Kirseline/PCB-OVEN/Documentation/pics/board_top_comp.JPG

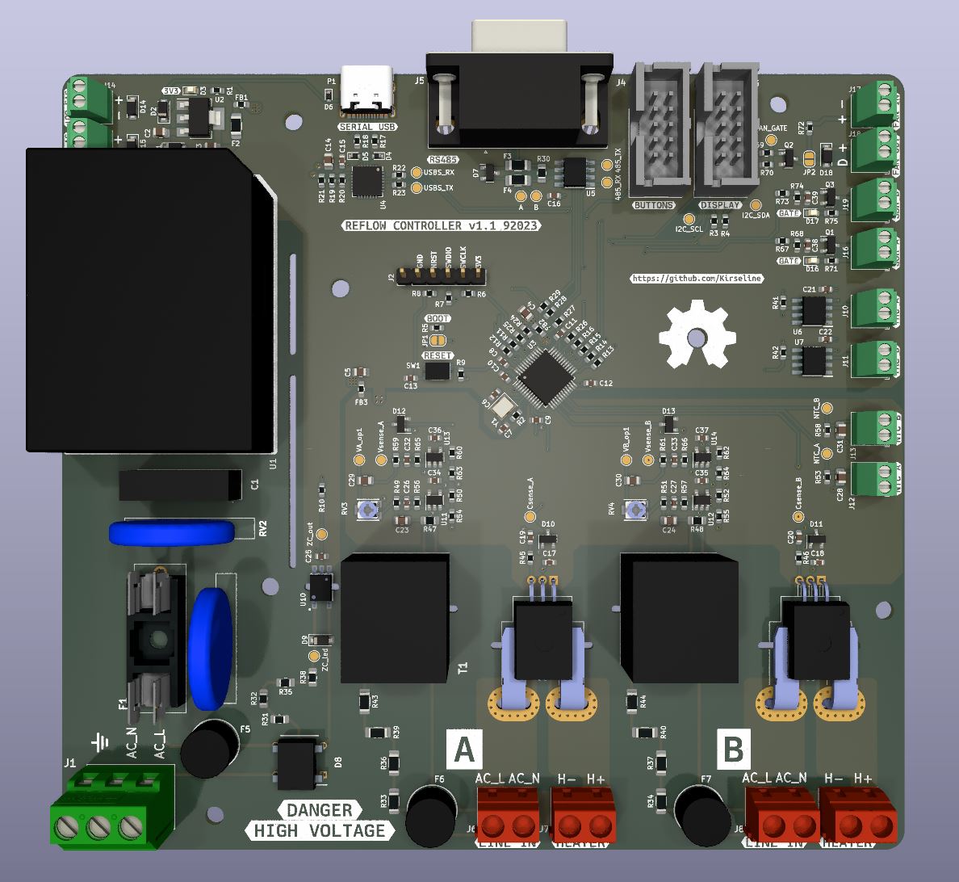
Documentation/pics/board_top_comp.JPG
