Kirseline/PCB-OVEN/Documentation/pics/board_comp.JPG

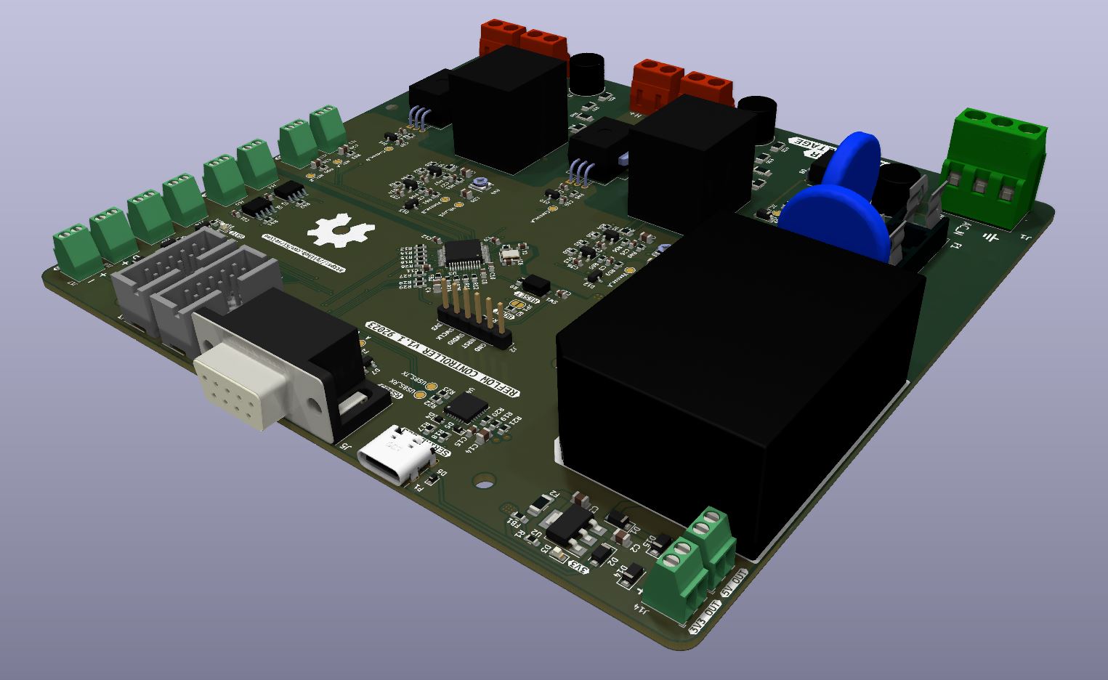
Documentation/pics/board_comp.JPG
