Kirseline/PCB-OVEN/MECHANICAL/chamber dimension.ods

Oven chamber dimension [m]:
height: | 0.275
length: | 0.019
width: | 0.260
volume[m³]: | 0.0013585
