Kirseline/PCB-OVEN/Documentation/pics/board_bot.JPG

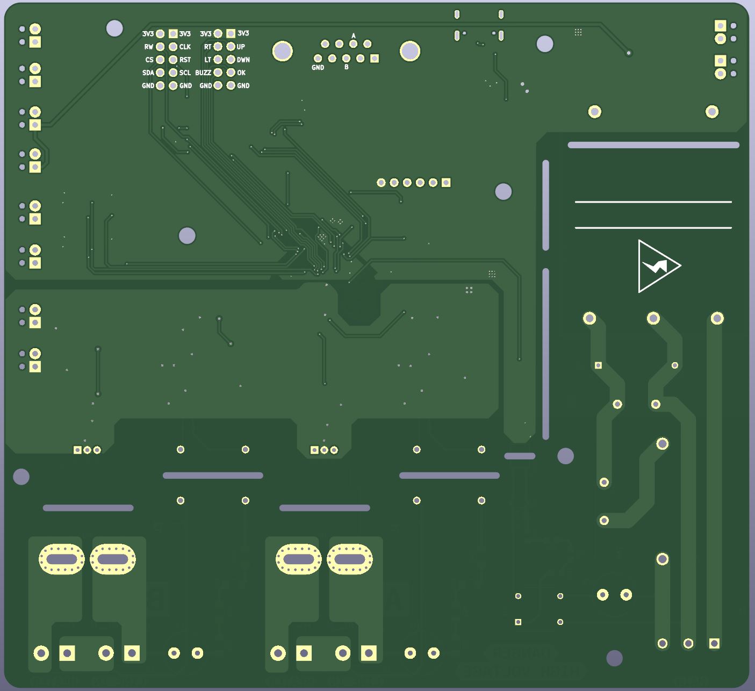
Documentation/pics/board_bot.JPG
