Kirseline/PCB-OVEN/Documentation/pics/board_top.JPG

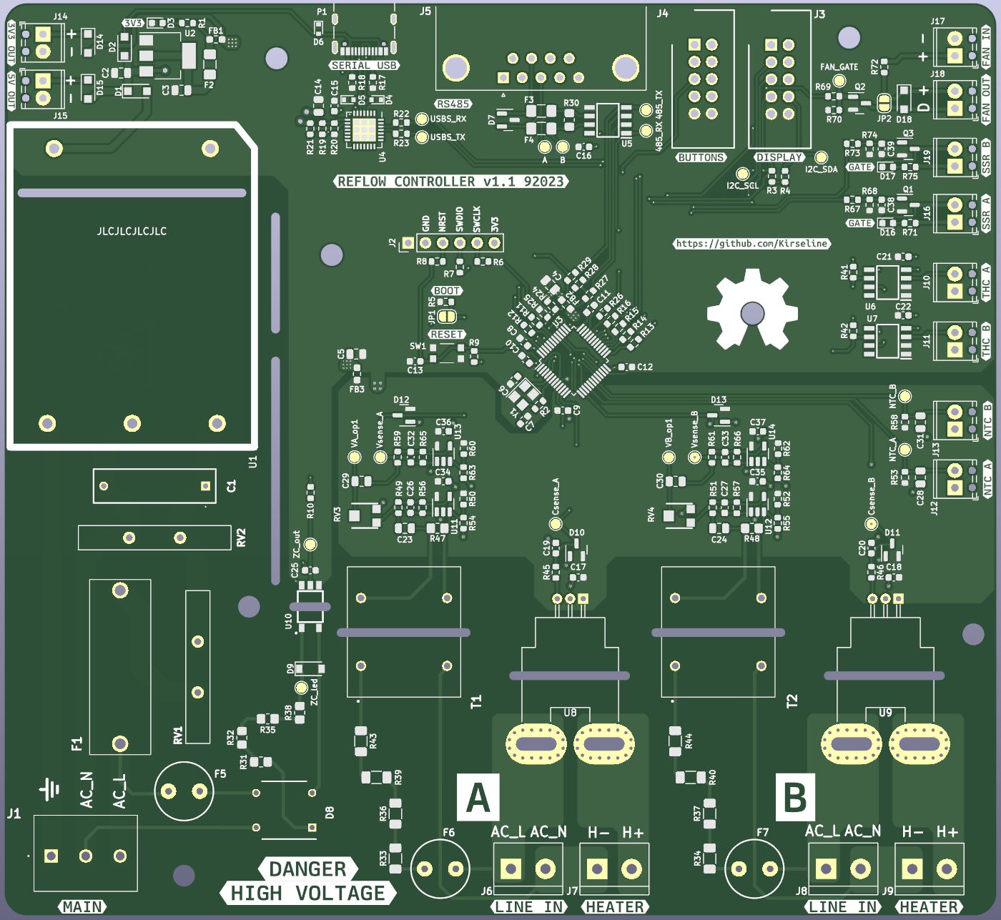
Documentation/pics/board_top.JPG
