Kirseline/PCB-OVEN/(threads)

Thread 1 (2023-09-15):

wrong footprint

Kirseline, 2023-09-15:
AC-DC converter LH05-10B05 footprint is wrong. Pin 8 and 4 should be swapped

Thread 2 (2024-12-19):

ZERO CROSSING NOISY

Kirseline, 2024-12-19:
noise problem in the zero crossing signal making it unusable

Kirseline, 2024-12-19:
added 1uF capacitor

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
