Kirseline/PCB-OVEN/Electrical/pcb/reflow_oven/fab/User Boards.pdf

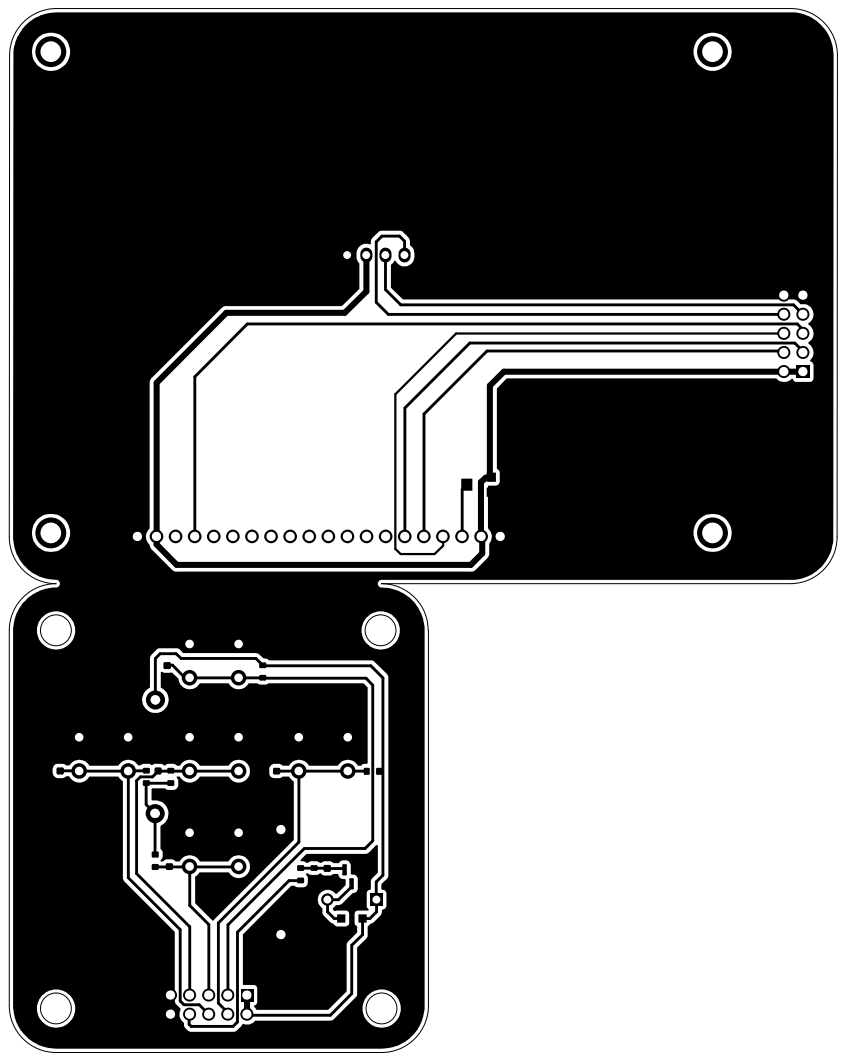
[picture p27: page 1]
