Kirseline/PCB-OVEN/Electrical/pcb/reflow_oven/UserBoard/User Board/User Board.kicad_pcb

## KiCad design Electrical/pcb/reflow_oven/UserBoard/User Board/User Board.kicad_pcb (2023-09-07)

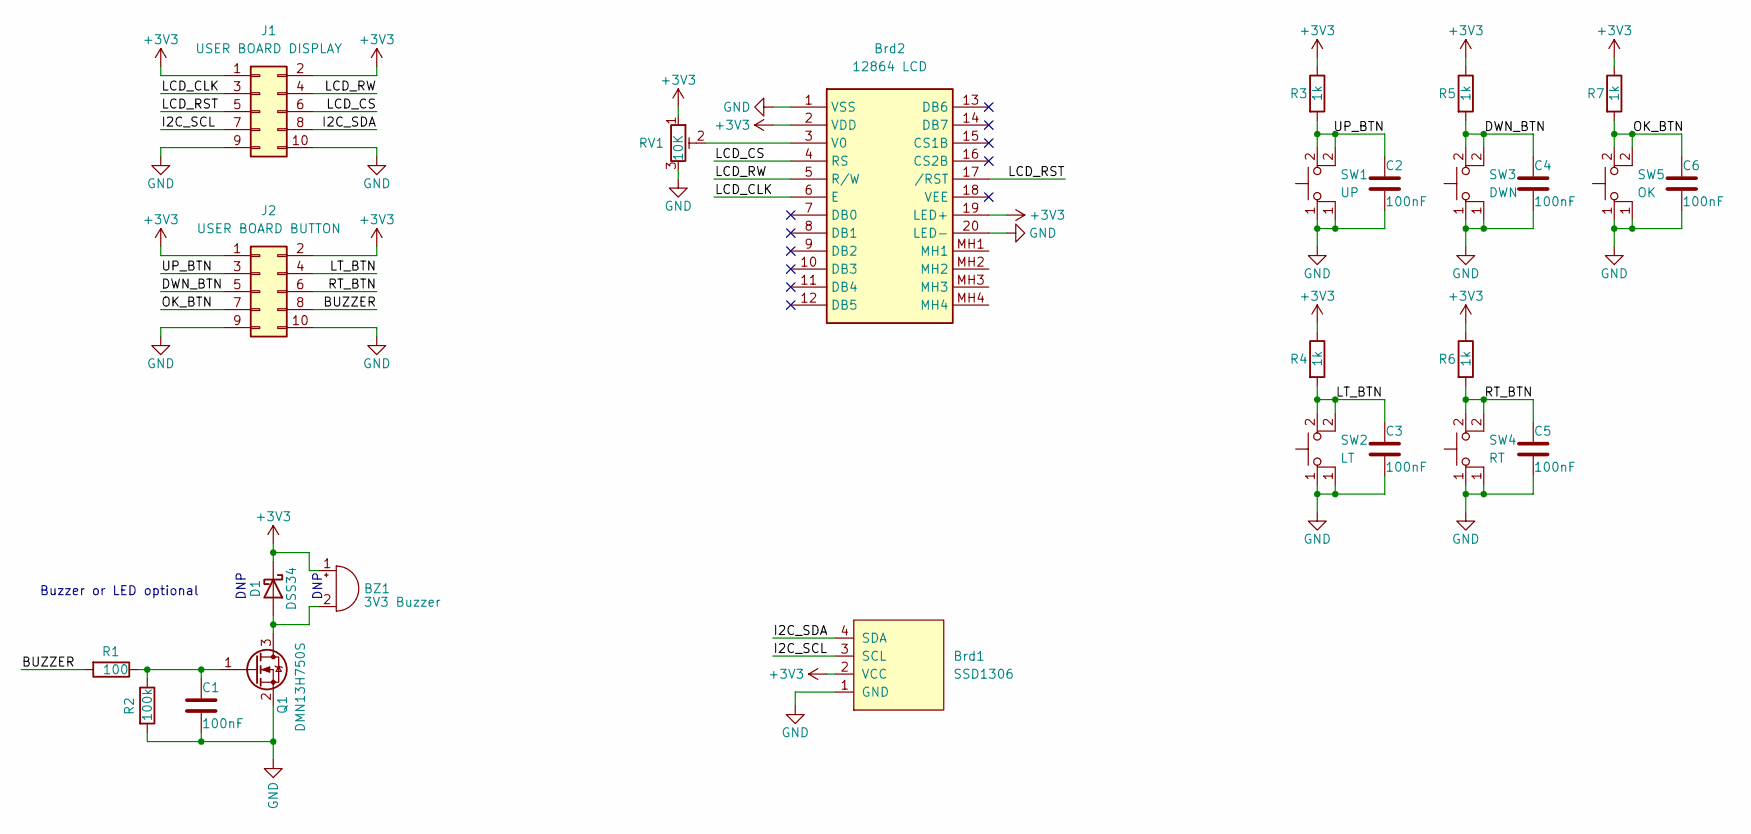
[picture p28: schematic User Board.kicad_sch]

Parts:
BZ1: 3V3 Buzzer; MagneticBuzzer_ProSignal_ABT-410-RC
Brd1: SSD1306; 128x64OLED
Brd2: 12864 LCD; NHD12864AZFSWGBWVZ; Manufacturer_Part_Number NHD-12864AZ-FSW-GBW-VZ; Mouser Part Number 763-12864AZ-FSW-GBW
C1, C2, C3, C4, C5, C6: 100nF; C_0603_1608Metric
D1: DSS34; D_SOD-123F
J1: USER BOARD DISPLAY; SHDR10W66P254_2X5_2019X914X986P
J2: USER BOARD BUTTON; SHDR10W66P254_2X5_2019X914X986P
Q1: DMN13H750S; SOT-23
R1: 100; R_0603_1608Metric
R2: 100k; R_0603_1608Metric
R3, R4, R5, R6, R7: 1k; R_0603_1608Metric
RV1: 10K; TC33X2503E
SW1: UP; SW_PUSH_6mm
SW2: LT; SW_PUSH_6mm
SW3: DWN; SW_PUSH_6mm
SW4: RT; SW_PUSH_6mm
SW5: OK; SW_PUSH_6mm

Connections:
+3V3: BZ1.1 (-), Brd1.2 (VCC), Brd2.2 (VDD), Brd2.19 (LED+), D1.1 (K), J1.1, J1.2, J2.1, J2.2, R3.1, R4.1, R5.1, R6.1, R7.1, RV1.1
/BUZZER: J2.8, R1.2
/DWN_BTN: C4.1, J2.5, R5.2, SW3.2
/I2C_SCL: Brd1.3 (SCL), J1.7
/I2C_SDA: Brd1.4 (SDA), J1.8
/LCD_CLK: Brd2.6 (E), J1.3
/LCD_CS: Brd2.4 (RS), J1.6
/LCD_RST: Brd2.17 (/RST), J1.5
/LCD_RW: Brd2.5 (R/W), J1.4
/LT_BTN: C3.1, J2.4, R4.2, SW2.2
/OK_BTN: C6.1, J2.7, R7.2, SW5.2
/RT_BTN: C5.1, J2.6, R6.2, SW4.2
/UP_BTN: C2.1, J2.3, R3.2, SW1.2
GND: Brd1.1 (GND), Brd2.1 (VSS), Brd2.20 (LED-), C1.2, C2.2, C3.2, C4.2, C5.2, C6.2, J1.9, J1.10, J2.9, J2.10, Q1.2 (S), R2.2, RV1.3, SW1.1, SW2.1, SW3.1, SW4.1, SW5.1
unnamed: BZ1.2 (+), D1.2 (A), Q1.3 (D)
unnamed: Brd2.3 (V0), RV1.2
unnamed: C1.1, Q1.1 (G), R1.1, R2.1

Notes on the sheet:
DNP
Buzzer or LED optional

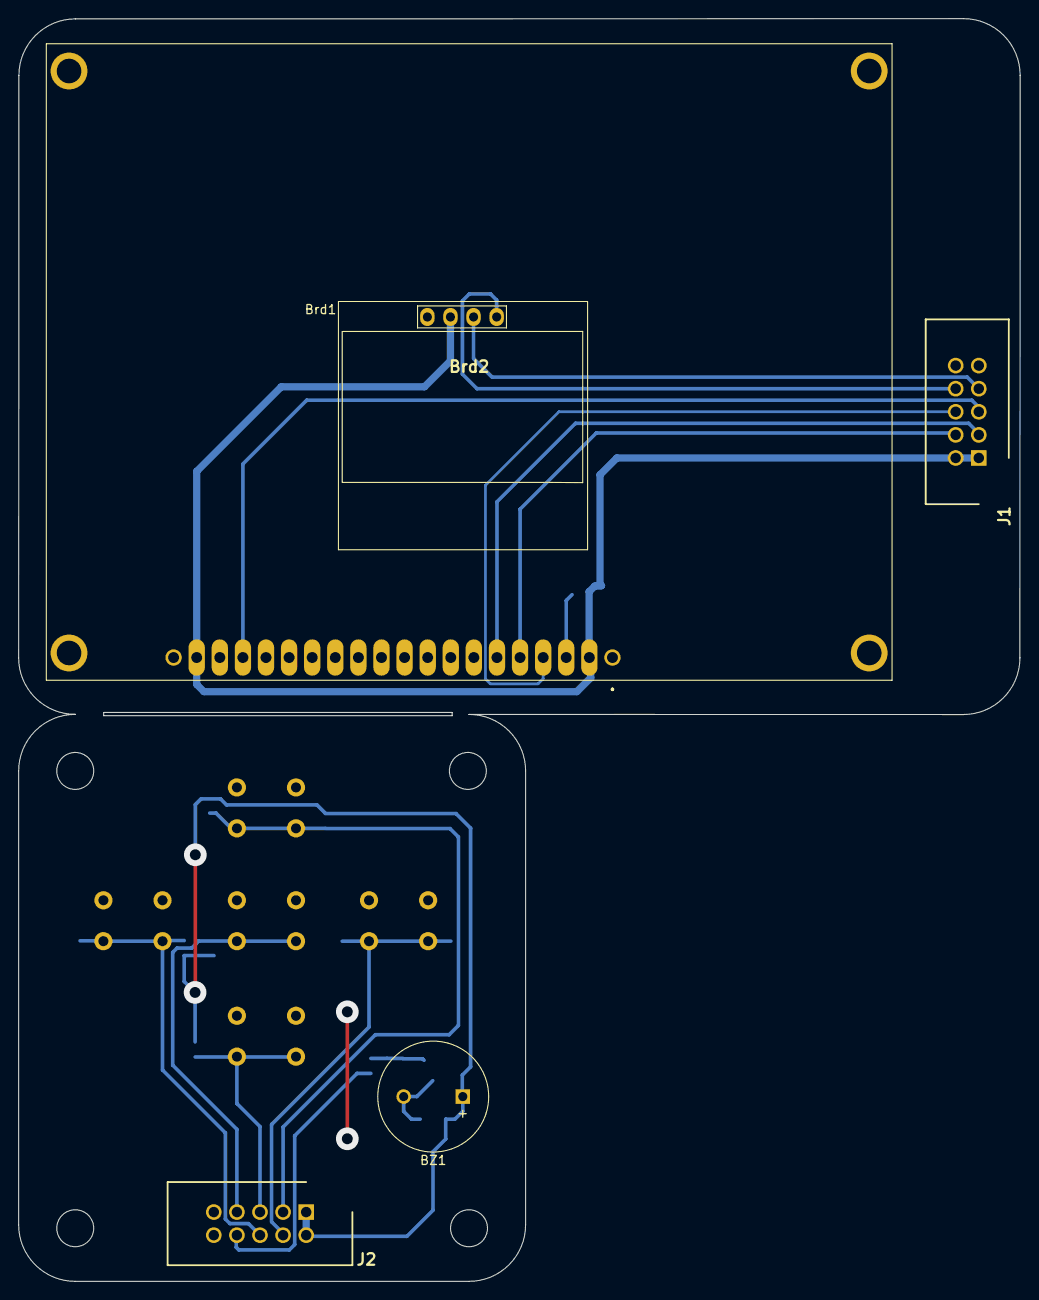
[picture p29: board User Board.kicad_pcb from above]

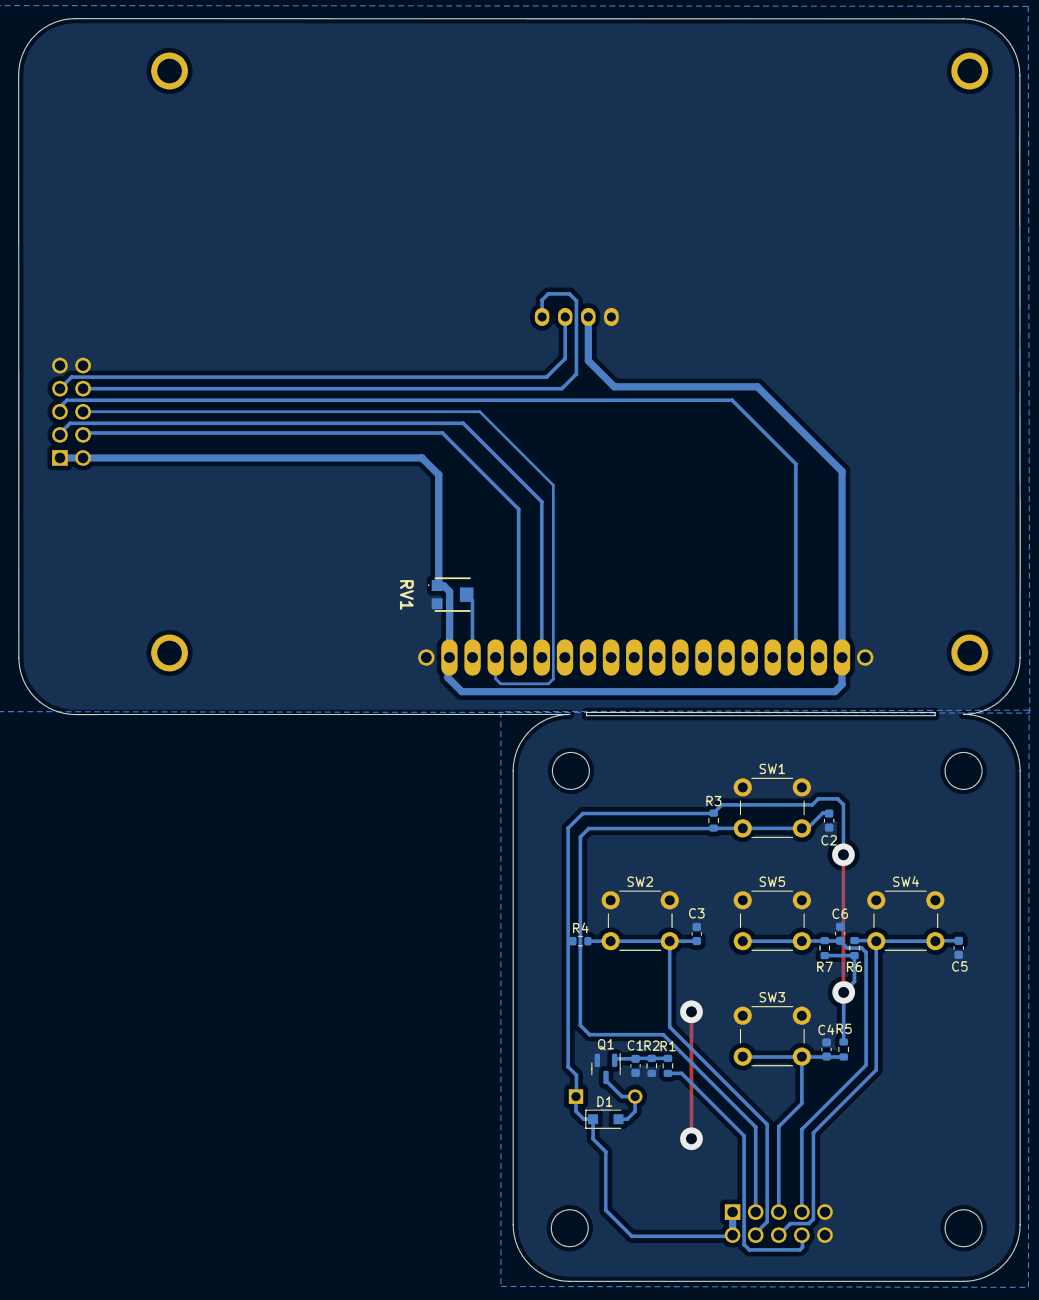
[picture p30: board User Board.kicad_pcb from below]

Board: 2 copper layers, 110.1 x 138.9 mm, 26 parts (21 on the bottom side), 17 nets.
