Kirseline/PCB-OVEN/Electrical/pcb/reflow_oven/reflow_oven.kicad_pcb

## KiCad design Electrical/pcb/reflow_oven/reflow_oven.kicad_pcb (2023-08-26)

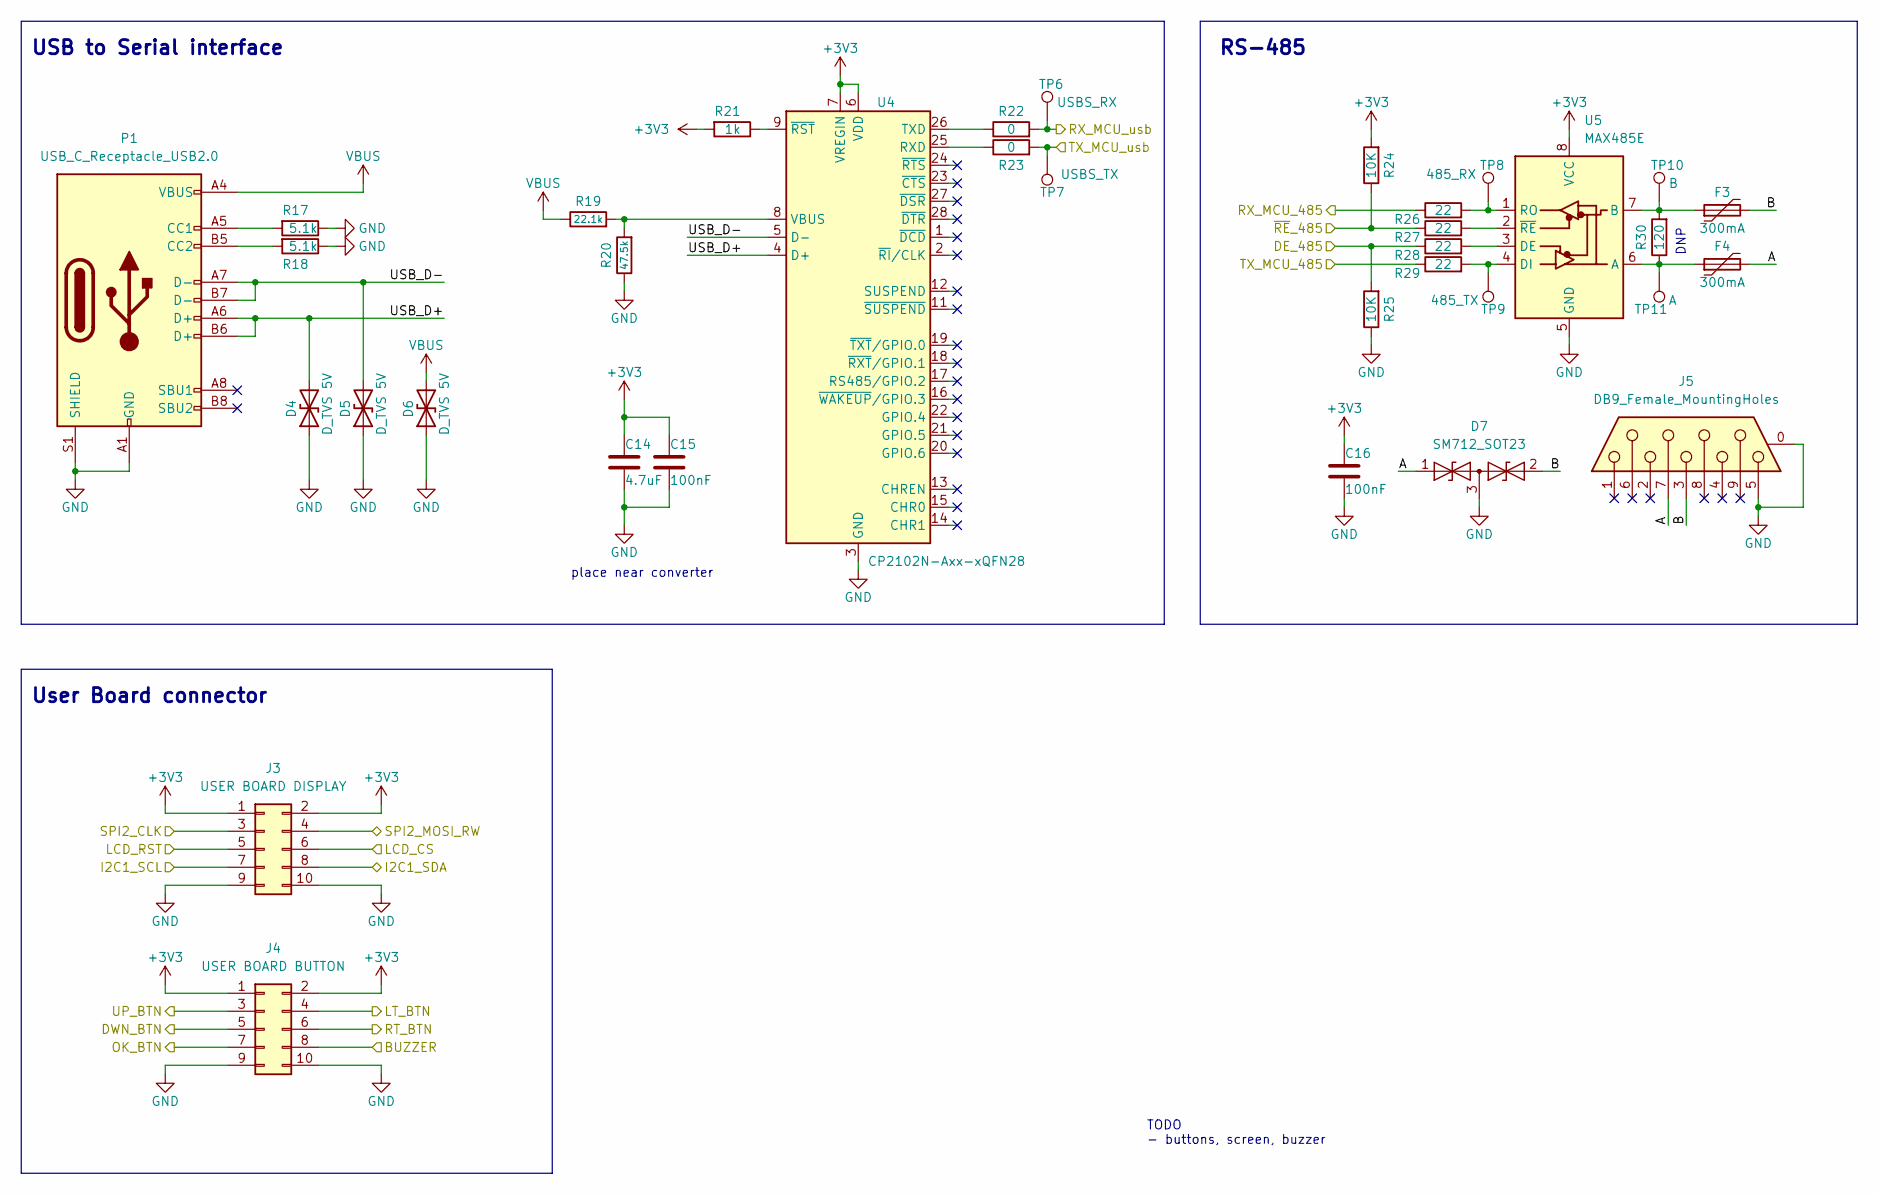
[picture p31: schematic Interfaces.kicad_sch, Reflow Controller]

Parts:
C14: 4.7uF; C_0805_2012Metric
C15, C16: 100nF; C_0603_1608Metric
D4, D5, D6: D_TVS 5V; D_SOD-523
D7: SM712_SOT23; SOT-23
F3, F4: 300mA; Fuse_1206_3216Metric_Pad1.42x1.75mm_HandSolder
J3: USER BOARD DISPLAY; SHDR10W66P254_2X5_2019X914X986P
J4: USER BOARD BUTTON; SHDR10W66P254_2X5_2019X914X986P
J5: DB9_Female_MountingHoles; DSUB-9_Female_Horizontal_P2.77x2.84mm_EdgePinOffset7.70mm_H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
P1: USB_C_Receptacle_USB2.0; USB_C_Receptacle_Palconn_UTC16-G
R17, R18: 5.1k; R_0603_1608Metric
R19: 22.1k; R_0603_1608Metric
R20: 47.5k; R_0603_1608Metric
R21: 1k; R_0603_1608Metric
R22, R23: 0; R_0603_1608Metric
R24, R25: 10K; R_0603_1608Metric
R26, R27, R28, R29: 22; R_0603_1608Metric
R30: 120; R_0805_2012Metric_Pad1.20x1.40mm_HandSolder
TP6: USBS_RX; TestPoint_Pad_D1.5mm
TP7: USBS_TX; TestPoint_Pad_D1.5mm
TP8: 485_RX; TestPoint_Pad_D1.5mm
TP9: 485_TX; TestPoint_Pad_D1.5mm
TP10: B; TestPoint_Pad_D1.5mm
TP11: A; TestPoint_Pad_D1.5mm
U4: CP2102N-Axx-xQFN28; QFN-28-1EP_5x5mm_P0.5mm_EP3.35x3.35mm
U5: MAX485E; SOIC127P600X175-8N

Connections:
+3V3: C14.1, C15.1, C16.1, J3.1, J3.2, J4.1, J4.2, R21.2, R24.2, U4.6 (VDD), U4.7 (VREGIN), U5.8 (VCC); also elsewhere on the board
/Interfaces/A: D7.1 (A1), F4.2, J5.7
/Interfaces/B: D7.2 (A2), F3.2, J5.3
/Interfaces/BUZZER: J4.8; also elsewhere on the board
/Interfaces/DE_485: R25.2, R28.1; also elsewhere on the board
/Interfaces/DWN_BTN: J4.5; also elsewhere on the board
/Interfaces/LCD_CS: J3.6; also elsewhere on the board
/Interfaces/LCD_RST: J3.5; also elsewhere on the board
/Interfaces/LT_BTN: J4.4; also elsewhere on the board
/Interfaces/OK_BTN: J4.7; also elsewhere on the board
/Interfaces/RT_BTN: J4.6; also elsewhere on the board
/Interfaces/RX_MCU_485: R26.1; also elsewhere on the board
/Interfaces/RX_MCU_usb: R22.2, TP6.1; also elsewhere on the board
/Interfaces/SPI2_CLK: J3.3; also elsewhere on the board
/Interfaces/SPI2_MOSI_RW: J3.4; also elsewhere on the board
/Interfaces/TX_MCU_485: R29.1; also elsewhere on the board
/Interfaces/TX_MCU_usb: R23.2, TP7.1; also elsewhere on the board
/Interfaces/UP_BTN: J4.3; also elsewhere on the board
/Interfaces/USB_D+: D4.2 (A2), P1.A6 (D+), P1.B6 (D+), U4.4 (D+)
/Interfaces/USB_D-: D5.2 (A2), P1.A7 (D-), P1.B7 (D-), U4.5 (D-)
/Interfaces/~RE_485: R24.1, R27.1; also elsewhere on the board
/MCU_User/I2C1_SCL: J3.7; also elsewhere on the board
/MCU_User/I2C1_SDA: J3.8; also elsewhere on the board
GND: C14.2, C15.2, C16.2, D4.1 (A1), D5.1 (A1), D6.1 (A1), D7.3 (common), J3.9, J3.10, J4.9, J4.10, J5.0 (PAD), J5.5, P1.A1 (GND), P1.A12 (GND), P1.B1 (GND), P1.B12 (GND), P1.S1 (SHIELD), R17.1, R18.1, R20.1, R25.1, U4.3 (GND), U4.29 (GND), U5.5 (GND); also elsewhere on the board
unnamed: F3.1, R30.2, TP10.1, U5.7 (B)
unnamed: F4.1, R30.1, TP11.1, U5.6 (A)
unnamed: P1.A5 (CC1), R17.2
unnamed: P1.B5 (CC2), R18.2
unnamed: R19.2, R20.2, U4.8 (VBUS)
unnamed: R21.1, U4.9 (~RST)
unnamed: R22.1, U4.26 (TXD)
unnamed: R23.1, U4.25 (RXD)
unnamed: R26.2, TP8.1, U5.1 (RO)
unnamed: R27.2, U5.2 (~RE)
unnamed: R28.2, U5.3 (DE)
unnamed: R29.2, TP9.1, U5.4 (DI)
VBUS: D6.2 (A2), P1.A4 (VBUS), P1.A9 (VBUS), P1.B4 (VBUS), P1.B9 (VBUS), R19.1; also elsewhere on the board

Notes on the sheet:
DNP
TODO - buttons, screen, buzzer
User Board connector
RS-485
place near converter
USB to Serial interface

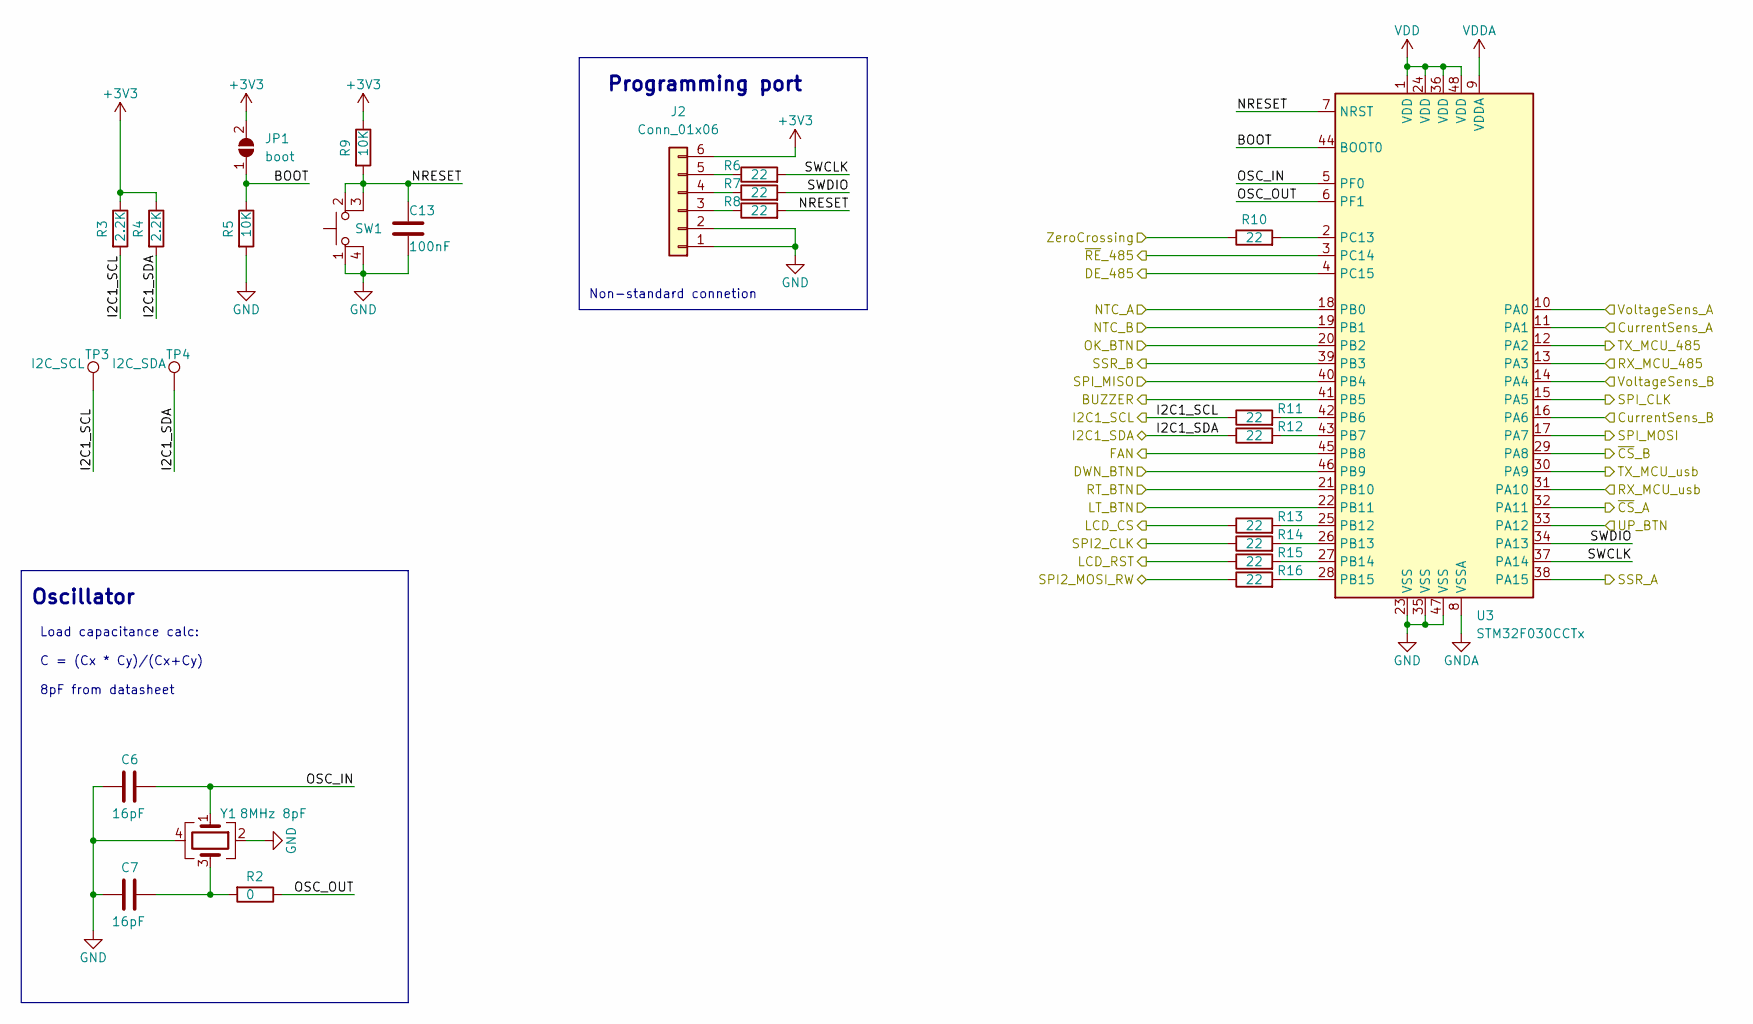
[picture p32: schematic MCU_User.kicad_sch, Reflow Controller]

Parts:
C6, C7: 16pF; C_0603_1608Metric
C13: 100nF; C_0603_1608Metric
J2: Conn_01x06; PinHeader_1x06_P2.54mm_Vertical
JP1: boot; SolderJumper-2_P1.3mm_Open_RoundedPad1.0x1.5mm
R2: 0; R_0603_1608Metric
R3, R4: 2.2K; R_0603_1608Metric
R5, R9: 10K; R_0603_1608Metric
R6, R7, R8, R10, R11, R12, R13, R14, R15, R16: 22; R_0603_1608Metric
SW1: SW_MEC_5E; KMR621NGLFS
TP3: I2C_SCL; TestPoint_Pad_D1.5mm
TP4: I2C_SDA; TestPoint_Pad_D1.5mm
U3: STM32F030CCTx; LQFP-48_7x7mm_P0.5mm
Y1: 8MHz 8pF; Crystal_SMD_TXC_7M-4Pin_3.2x2.5mm

Connections:
+3V3: J2.6, JP1.2 (B), R3.1, R4.1, R9.1; also elsewhere on the board
/Actuation/FAN: U3.45 (PB8); also elsewhere on the board
/Actuation/SSR_A: U3.38 (PA15); also elsewhere on the board
/Actuation/SSR_B: U3.39 (PB3); also elsewhere on the board
/Interfaces/BUZZER: U3.41 (PB5); also elsewhere on the board
/Interfaces/DE_485: U3.4 (PC15); also elsewhere on the board
/Interfaces/DWN_BTN: U3.46 (PB9); also elsewhere on the board
/Interfaces/LCD_CS: R13.1; also elsewhere on the board
/Interfaces/LCD_RST: R15.1; also elsewhere on the board
/Interfaces/LT_BTN: U3.22 (PB11); also elsewhere on the board
/Interfaces/OK_BTN: U3.20 (PB2); also elsewhere on the board
/Interfaces/RT_BTN: U3.21 (PB10); also elsewhere on the board
/Interfaces/RX_MCU_485: U3.13 (PA3); also elsewhere on the board
/Interfaces/RX_MCU_usb: U3.31 (PA10); also elsewhere on the board
/Interfaces/SPI2_CLK: R14.1; also elsewhere on the board
/Interfaces/SPI2_MOSI_RW: R16.1; also elsewhere on the board
/Interfaces/TX_MCU_485: U3.12 (PA2); also elsewhere on the board
/Interfaces/TX_MCU_usb: U3.30 (PA9); also elsewhere on the board
/Interfaces/UP_BTN: U3.33 (PA12); also elsewhere on the board
/Interfaces/~RE_485: U3.3 (PC14); also elsewhere on the board
/MCU_User/BOOT: JP1.1 (A), R5.1, U3.44 (BOOT0)
/MCU_User/I2C1_SCL: R3.2, R11.1, TP3.1; also elsewhere on the board
/MCU_User/I2C1_SDA: R4.2, R12.1, TP4.1; also elsewhere on the board
/MCU_User/NRESET: C13.1, R8.2, R9.2, SW1.2, SW1.3 (K), U3.7 (NRST)
/MCU_User/NTC_A: U3.18 (PB0); also elsewhere on the board
/MCU_User/NTC_B: U3.19 (PB1); also elsewhere on the board
/MCU_User/OSC_IN: C6.1, U3.5 (PF0), Y1.1
/MCU_User/OSC_OUT: R2.1, U3.6 (PF1)
/MCU_User/SPI_CLK: U3.15 (PA5); also elsewhere on the board
/MCU_User/SPI_MISO: U3.40 (PB4); also elsewhere on the board
/MCU_User/SPI_MOSI: U3.17 (PA7)
/MCU_User/SWCLK: R6.2, U3.37 (PA14)
/MCU_User/SWDIO: R7.2, U3.34 (PA13)
/MCU_User/ZeroCrossing: R10.1; also elsewhere on the board
/MCU_User/~CS_A: U3.32 (PA11); also elsewhere on the board
/MCU_User/~CS_B: U3.29 (PA8); also elsewhere on the board
/Sensors/Csense_A: U3.11 (PA1); also elsewhere on the board
/Sensors/Csense_B: U3.16 (PA6); also elsewhere on the board
/Sensors/Vsense_A: U3.10 (PA0); also elsewhere on the board
/Sensors/Vsense_B: U3.14 (PA4); also elsewhere on the board
GND: C6.2, C7.2, C13.2, J2.1, J2.2, R5.2, SW1.1, SW1.4, U3.23 (VSS), U3.35 (VSS), U3.47 (VSS), Y1.2, Y1.4; also elsewhere on the board
GNDA: U3.8 (VSSA); also elsewhere on the board
unnamed: C7.1, R2.2, Y1.3
unnamed: J2.3, R8.1
unnamed: J2.4, R7.1
unnamed: J2.5, R6.1
unnamed: R10.2, U3.2 (PC13)
unnamed: R11.2, U3.42 (PB6)
unnamed: R12.2, U3.43 (PB7)
unnamed: R13.2, U3.25 (PB12)
unnamed: R14.2, U3.26 (PB13)
unnamed: R15.2, U3.27 (PB14)
unnamed: R16.2, U3.28 (PB15)
VDD: U3.1 (VDD), U3.24 (VDD), U3.36 (VDD), U3.48 (VDD); also elsewhere on the board
VDDA: U3.9 (VDDA); also elsewhere on the board

Notes on the sheet:
Programming port
Load capacitance calc: C = (Cx * Cy)/(Cx+Cy) 8pF from datasheet
Non-standard connetion
Oscillator

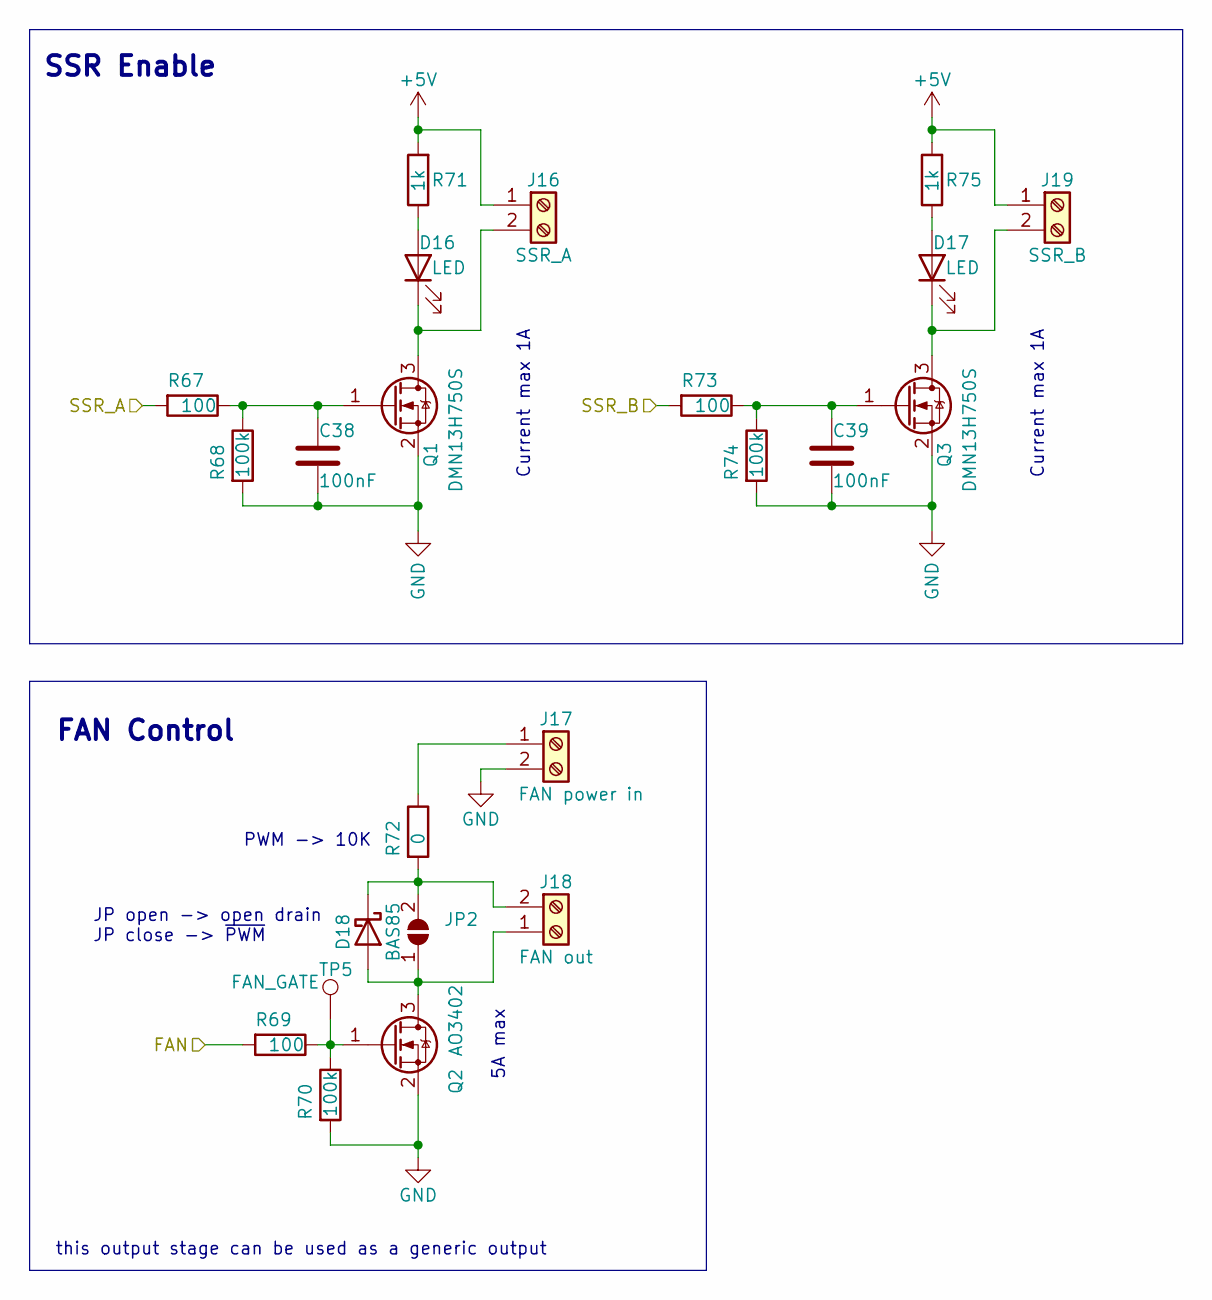
[picture p33: schematic Actuation.kicad_sch, Reflow Controller]

Parts:
C38, C39: 100nF; C_0603_1608Metric
D16, D17: LED; LED_0603_1608Metric
D18: BAS85; D_SOD-123F
J16: SSR_A; TerminalBlock_Phoenix_MPT-0,5-2-2.54_1x02_P2.54mm_Horizontal
J17: FAN power in; TerminalBlock_Phoenix_MPT-0,5-2-2.54_1x02_P2.54mm_Horizontal
J18: FAN out; TerminalBlock_Phoenix_MPT-0,5-2-2.54_1x02_P2.54mm_Horizontal
J19: SSR_B; TerminalBlock_Phoenix_MPT-0,5-2-2.54_1x02_P2.54mm_Horizontal
JP2: SolderJumper_2_Open; SolderJumper-2_P1.3mm_Open_RoundedPad1.0x1.5mm
Q1, Q3: DMN13H750S; SOT-23
Q2: AO3402; SOT-23
R67, R69, R73: 100; R_0603_1608Metric
R68, R70, R74: 100k; R_0603_1608Metric
R71, R75: 1k; R_0603_1608Metric
R72: 0; R_0603_1608Metric
TP5: FAN_GATE; TestPoint_Pad_D1.5mm

Connections:
+5V: J16.1, J19.1, R71.2, R75.2; also elsewhere on the board
/Actuation/FAN: R69.2; also elsewhere on the board
/Actuation/SSR_A: R67.2; also elsewhere on the board
/Actuation/SSR_B: R73.2; also elsewhere on the board
GND: C38.2, C39.2, J17.2, Q1.2 (S), Q2.2 (S), Q3.2 (S), R68.2, R70.2, R74.2; also elsewhere on the board
unnamed: C38.1, Q1.1 (G), R67.1, R68.1
unnamed: C39.1, Q3.1 (G), R73.1, R74.1
unnamed: D16.1 (K), J16.2, Q1.3 (D)
unnamed: D16.2 (A), R71.1
unnamed: D17.1 (K), J19.2, Q3.3 (D)
unnamed: D17.2 (A), R75.1
unnamed: D18.1 (K), J18.2, JP2.2 (B), R72.2
unnamed: D18.2 (A), J18.1, JP2.1 (A), Q2.3 (D)
unnamed: J17.1, R72.1
unnamed: Q2.1 (G), R69.1, R70.1, TP5.1

Notes on the sheet:
PWM -> 10K
Current max 1A
FAN Control
5A max
SSR Enable
this output stage can be used as a generic output
JP open -> open drain JP close -> ~{PWM}

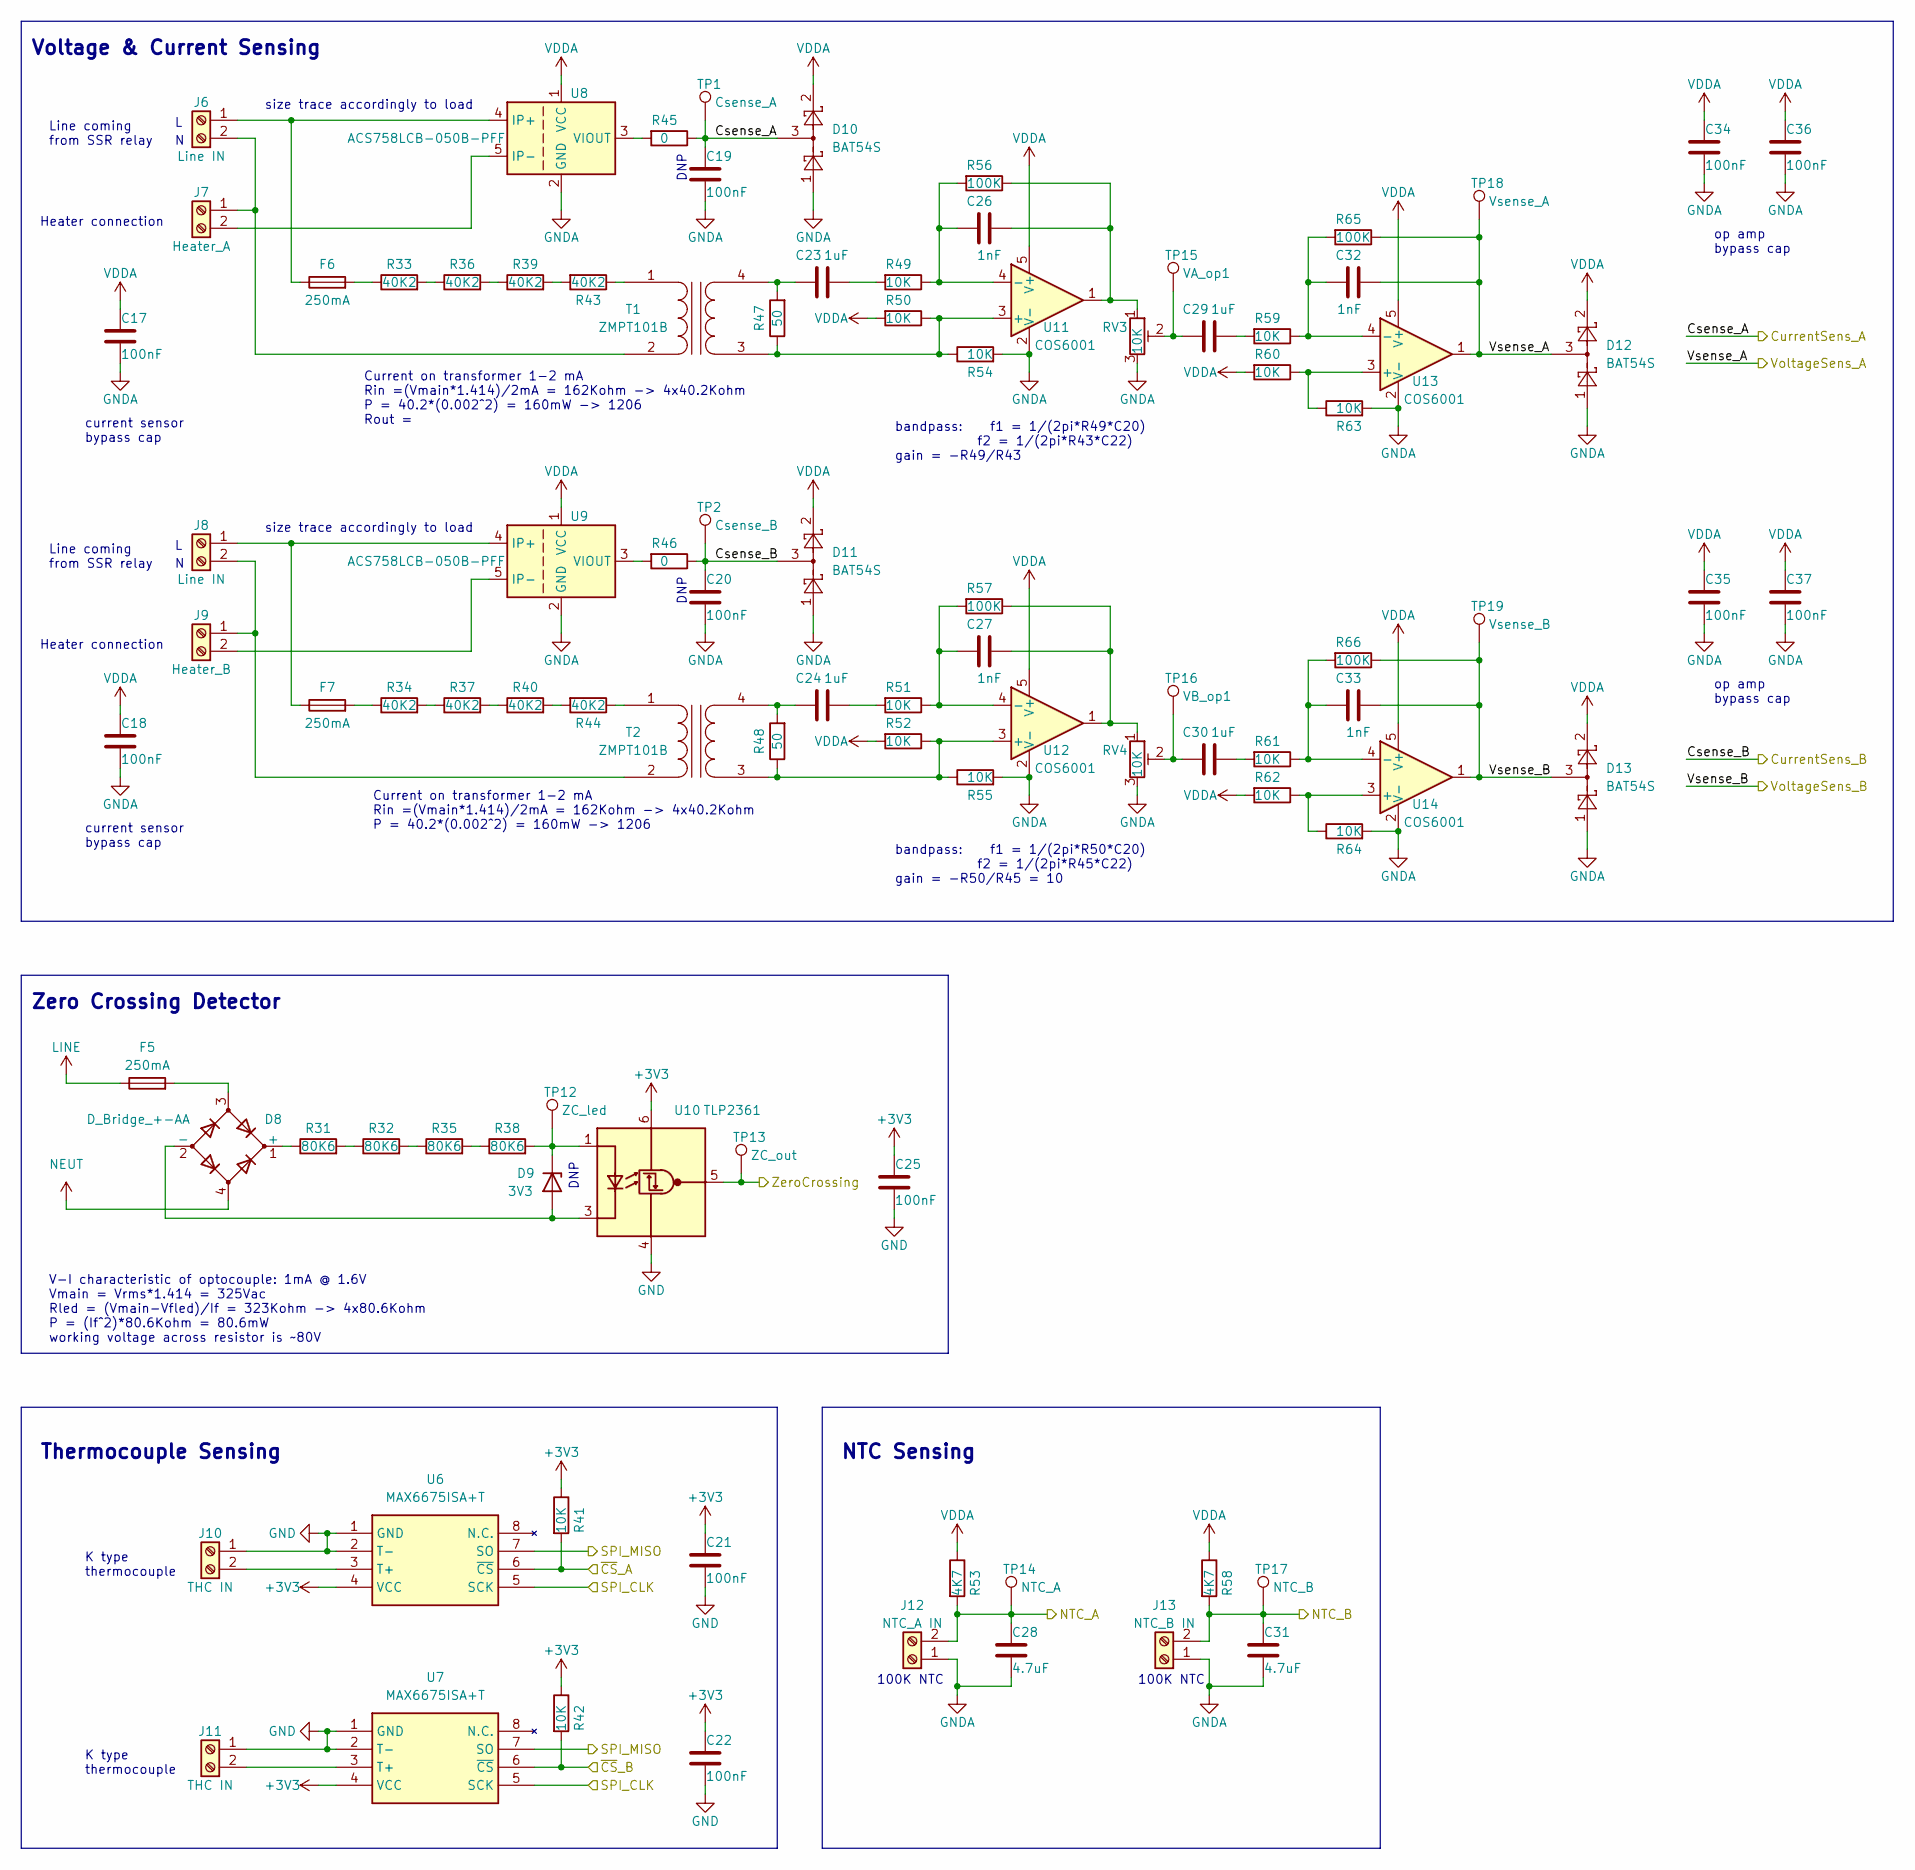
[picture p34: schematic Sensors.kicad_sch, Reflow Controller]

Parts:
C17, C18, C19, C20, C21, C22, C25, C34, C35, C36, C37: 100nF; C_0603_1608Metric
C23, C24, C29, C30: 1uF; C_0805_2012Metric
C26, C27, C32, C33: 1nF; C_0603_1608Metric
C28, C31: 4.7uF; C_0805_2012Metric
D8: D_Bridge_+-AA; DIP825W58P510L832H472Q4N
D9: 3V3; D_SOD-123
D10, D11, D12, D13: BAT54S; SOT-23
F5, F6, F7: 250mA; Circular_fuse
J6, J8: Line IN; TerminalBlock_bornier-2_P5.08mm
J7: Heater_A; TerminalBlock_bornier-2_P5.08mm
J9: Heater_B; TerminalBlock_bornier-2_P5.08mm
J10, J11: THC IN; TerminalBlock_Phoenix_MPT-0,5-2-2.54_1x02_P2.54mm_Horizontal
J12: NTC_A IN; TerminalBlock_Phoenix_MPT-0,5-2-2.54_1x02_P2.54mm_Horizontal
J13: NTC_B IN; TerminalBlock_Phoenix_MPT-0,5-2-2.54_1x02_P2.54mm_Horizontal
R31, R32, R35, R38: 80K6; R_0805_2012Metric_Pad1.20x1.40mm_HandSolder
R33, R34, R36, R37, R39, R40, R43, R44: 40K2; R_1206_3216Metric_Pad1.30x1.75mm_HandSolder
R41, R42, R49, R50, R51, R52, R54, R55, R59, R60, R61, R62, R63, R64: 10K; R_0603_1608Metric
R45, R46: 0; R_0603_1608Metric
R47, R48: 50; R_0805_2012Metric_Pad1.20x1.40mm_HandSolder
R53, R58: 4K7; R_0603_1608Metric
R56, R57, R65, R66: 100K; R_0603_1608Metric
RV3, RV4: 10K; TC33X2503E
T1, T2: ZMPT101B
TP1: Csense_A; TestPoint_Pad_D1.5mm
TP2: Csense_B; TestPoint_Pad_D1.5mm
TP12: ZC_led; TestPoint_Pad_D1.5mm
TP13: ZC_out; TestPoint_Pad_D1.5mm
TP14: NTC_A; TestPoint_Pad_D1.5mm
TP15: VA_op1; TestPoint_Pad_D1.5mm
TP16: VB_op1; TestPoint_Pad_D1.5mm
TP17: NTC_B; TestPoint_Pad_D1.5mm
TP18: Vsense_A; TestPoint_Pad_D1.5mm
TP19: Vsense_B; TestPoint_Pad_D1.5mm
U6, U7: MAX6675ISA+T; SOIC127P600X175-8N; Mouser Part Number 700-MAX6675ISAT
U8, U9: ACS758LCB-050B-PFF; Allegro_CB_PFF
U10: TLP2361; 11-4L1S_5-PIN-SOIC_
U11, U12, U13, U14: COS6001; SOT-23-5

Connections:
+3V3: C21.1, C22.1, C25.1, R41.1, R42.1, U6.4 (VCC), U7.4 (VCC), U10.6 (VDD); also elsewhere on the board
/MCU_User/NTC_A: C28.1, J12.2, R53.2, TP14.1; also elsewhere on the board
/MCU_User/NTC_B: C31.1, J13.2, R58.2, TP17.1; also elsewhere on the board
/MCU_User/SPI_CLK: U6.5 (SCK), U7.5 (SCK); also elsewhere on the board
/MCU_User/SPI_MISO: U6.7 (SO), U7.7 (SO); also elsewhere on the board
/MCU_User/ZeroCrossing: TP13.1, U10.5 (VO); also elsewhere on the board
/MCU_User/~CS_A: R41.2, U6.6 (~CS); also elsewhere on the board
/MCU_User/~CS_B: R42.2, U7.6 (~CS); also elsewhere on the board
/Sensors/Csense_A: C19.1, D10.3, R45.1, TP1.1; also elsewhere on the board
/Sensors/Csense_B: C20.1, D11.3, R46.1, TP2.1; also elsewhere on the board
/Sensors/Vsense_A: C32.2, D12.3, R65.1, TP18.1, U13.1; also elsewhere on the board
/Sensors/Vsense_B: C33.2, D13.3, R66.1, TP19.1, U14.1; also elsewhere on the board
GND: C21.2, C22.2, C25.2, J10.1, J11.1, U6.1 (GND), U6.2 (T-), U7.1 (GND), U7.2 (T-), U10.4 (GND); also elsewhere on the board
GNDA: C17.2, C18.2, C19.2, C20.2, C28.2, C31.2, C34.2, C35.2, C36.2, C37.2, D10.1, D11.1, D12.1, D13.1, J12.1, J13.1, R54.2, R55.2, R63.2, R64.2, RV3.3, RV4.3, U8.2 (GND), U9.2 (GND), U11.2 (V-), U12.2 (V-), U13.2 (V-), U14.2 (V-); also elsewhere on the board
LINE: F5.1; also elsewhere on the board
NEUT: D8.4; also elsewhere on the board
unnamed: C23.1, R47.2, T1.4 (SB)
unnamed: C23.2, R49.2
unnamed: C24.1, R48.2, T2.4 (SB)
unnamed: C24.2, R51.2
unnamed: C26.1, R49.1, R56.2, U11.4 (-)
unnamed: C26.2, R56.1, RV3.1, U11.1
unnamed: C27.1, R51.1, R57.2, U12.4 (-)
unnamed: C27.2, R57.1, RV4.1, U12.1
unnamed: C29.1, RV3.2, TP15.1
unnamed: C29.2, R59.2
unnamed: C30.1, RV4.2, TP16.1
unnamed: C30.2, R61.2
unnamed: C32.1, R59.1, R65.2, U13.4 (-)
unnamed: C33.1, R61.1, R66.2, U14.4 (-)
unnamed: D8.1 (+), R31.1
unnamed: D8.2 (-), D9.2 (A), U10.3 (K)
unnamed: D8.3, F5.2
unnamed: D9.1 (K), R38.2, TP12.1, U10.1 (A)
unnamed: F6.1, J6.1 (Pin_2), U8.4 (IP+)
unnamed: F6.2, R33.1
unnamed: F7.1, J8.1, U9.4 (IP+)
unnamed: F7.2, R34.1
unnamed: J6.2 (Pin_1), J7.1 (Pin_2), T1.2 (AB)
unnamed: J7.2 (Pin_1), U8.5 (IP-)
unnamed: J8.2, J9.1, T2.2 (AB)
unnamed: J9.2, U9.5 (IP-)
unnamed: J10.2, U6.3 (T+)
unnamed: J11.2, U7.3 (T+)
unnamed: R31.2, R32.1
unnamed: R32.2, R35.1
unnamed: R33.2, R36.1
unnamed: R34.2, R37.1
unnamed: R35.2, R38.1
unnamed: R36.2, R39.1
unnamed: R37.2, R40.1
unnamed: R39.2, R43.2
unnamed: R40.2, R44.2
unnamed: R43.1, T1.1 (AA)
unnamed: R44.1, T2.1 (AA)
unnamed: R45.2, U8.3 (VIOUT)
unnamed: R46.2, U9.3 (VIOUT)
unnamed: R47.1, R50.1, R54.1, T1.3 (SA), U11.3 (+)
unnamed: R48.1, R52.1, R55.1, T2.3 (SA), U12.3 (+)
unnamed: R60.1, R63.1, U13.3 (+)
unnamed: R62.1, R64.1, U14.3 (+)
VDDA: C17.1, C18.1, C34.1, C35.1, C36.1, C37.1, D10.2, D11.2, D12.2, D13.2, R50.2, R52.2, R53.1, R58.1, R60.2, R62.2, U8.1 (VCC), U9.1 (VCC), U11.5 (V+), U12.5 (V+), U13.5 (V+), U14.5 (V+); also elsewhere on the board

Notes on the sheet:
V-I characteristic of optocouple: 1mA @ 1.6V Vmain = Vrms*1.414 = 325Vac Rled = (Vmain-Vfled)/If = 323Kohm -> 4x80.6Kohm P = (If^2)*80.6Kohm = 80.6mW working voltage across resistor is ~80V
Line coming from SSR relay
Voltage & Current Sensing
100K NTC
size trace accordingly to load
Current on transformer 1-2 mA Rin =(Vmain*1.414)/2mA = 162Kohm -> 4x40.2Kohm P = 40.2*(0.002^2) = 160mW -> 1206 Rout =
Current on transformer 1-2 mA Rin =(Vmain*1.414)/2mA = 162Kohm -> 4x40.2Kohm P = 40.2*(0.002^2) = 160mW -> 1206
bandpass: f1 = 1/(2pi*R50*C20) f2 = 1/(2pi*R45*C22) gain = -R50/R45 = 10
Heater connection
DNP
op amp bypass cap
NTC Sensing
K type thermocouple
bandpass: f1 = 1/(2pi*R49*C20) f2 = 1/(2pi*R43*C22) gain = -R49/R43
Zero Crossing Detector
DNP
current sensor bypass cap
Thermocouple Sensing
