Kirseline/PCB-OVEN/Electrical/pcb/reflow_oven/reflow_oven.kicad_pcb

## KiCad design Electrical/pcb/reflow_oven/reflow_oven.kicad_pcb (continued)

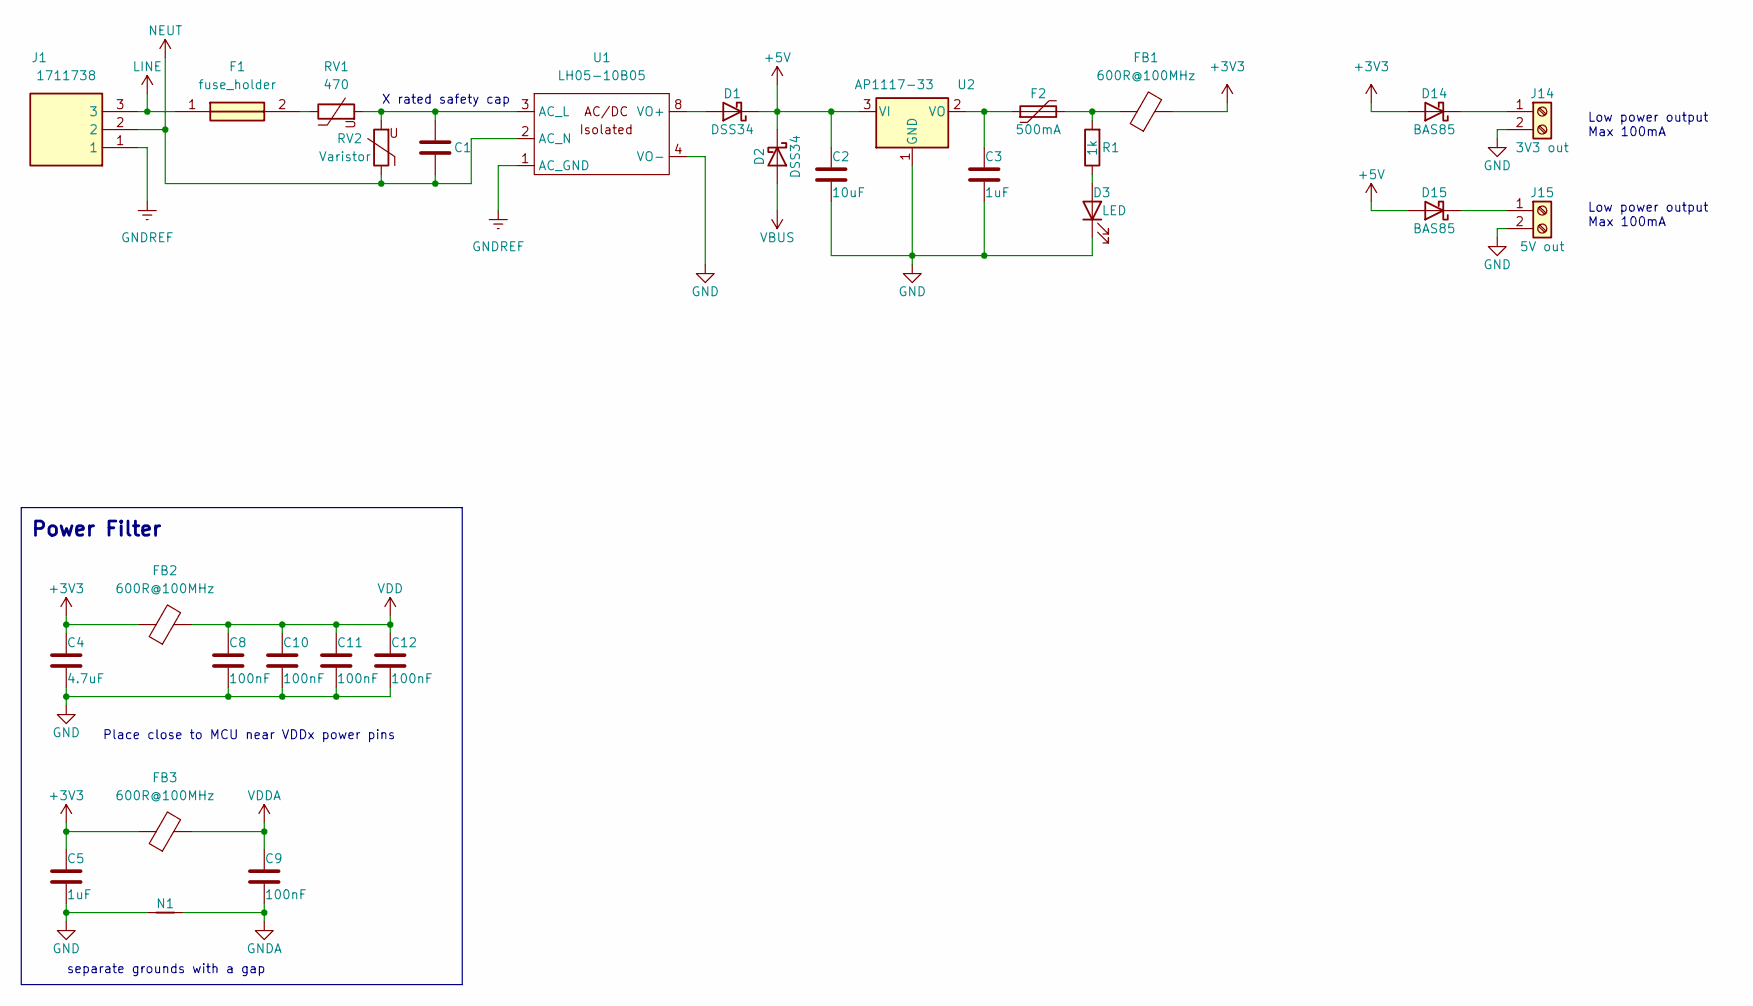
[picture p35: schematic Power Stage.kicad_sch, Reflow Controller]

Parts:
C1: C; MXH104K305E10
C2: 10uF; C_0805_2012Metric
C3, C5: 1uF; C_0805_2012Metric
C4: 4.7uF; C_0805_2012Metric
C8, C9, C10, C11, C12: 100nF; C_0603_1608Metric
D1, D2: DSS34; D_SOD-123F
D3: LED; LED_0603_1608Metric
D14, D15: BAS85; D_SOD-123F
F1: fuse_holder; 64600001223; Mouser Part Number 576-64600001223
F2: 500mA; Fuse_1206_3216Metric_Pad1.42x1.75mm_HandSolder
FB1, FB2, FB3: 600R@100MHz; R_0603_1608Metric_Pad0.98x0.95mm_HandSolder
J1: 1711738; Mouser Part Number 651-1711738
J14: 3V3 out; TerminalBlock_Phoenix_MPT-0,5-2-2.54_1x02_P2.54mm_Horizontal
J15: 5V out; TerminalBlock_Phoenix_MPT-0,5-2-2.54_1x02_P2.54mm_Horizontal
N1: Net-Tie_2; NetTie-2_SMD_Pad2.0mm
R1: 1k; R_0603_1608Metric
RV1: 470; MOV_20D241k
RV2: Varistor; MOV_20D241k
U1: LH05-10B05; LH05-13B05
U2: AP1117-33; SOT-223-3_TabPin2

Connections:
+3V3: C4.1, C5.1, D14.2 (A), FB1.2, FB2.1, FB3.1; also elsewhere on the board
+5V: C2.1, D1.1 (K), D2.1 (K), D15.2 (A), U2.3 (VI); also elsewhere on the board
GND: C2.2, C3.2, C4.2, C5.2, C8.2, C10.2, C11.2, C12.2, D3.1 (K), J14.2, J15.2, N1.1, U1.4 (VO-), U2.1 (GND); also elsewhere on the board
GNDA: C9.2, N1.2; also elsewhere on the board
GNDREF: J1.1, U1.1 (AC_GND)
LINE: F1.1, J1.3; also elsewhere on the board
NEUT: C1.2, J1.2, RV2.1, U1.2 (AC_N); also elsewhere on the board
unnamed: C1.1, RV1.2, RV2.2, U1.3 (AC_L)
unnamed: C3.1, F2.1, U2.2 (VO)
unnamed: D1.2 (A), U1.8 (VO+)
unnamed: D3.2 (A), R1.1
unnamed: D14.1 (K), J14.1
unnamed: D15.1 (K), J15.1
unnamed: F1.2, RV1.1
unnamed: F2.2, FB1.1, R1.2
VBUS: D2.2 (A); also elsewhere on the board
VDD: C8.1, C10.1, C11.1, C12.1, FB2.2; also elsewhere on the board
VDDA: C9.1, FB3.2; also elsewhere on the board

Notes on the sheet:
Place close to MCU near VDDx power pins
Low power output Max 100mA
X rated safety cap
Power Filter
separate grounds with a gap

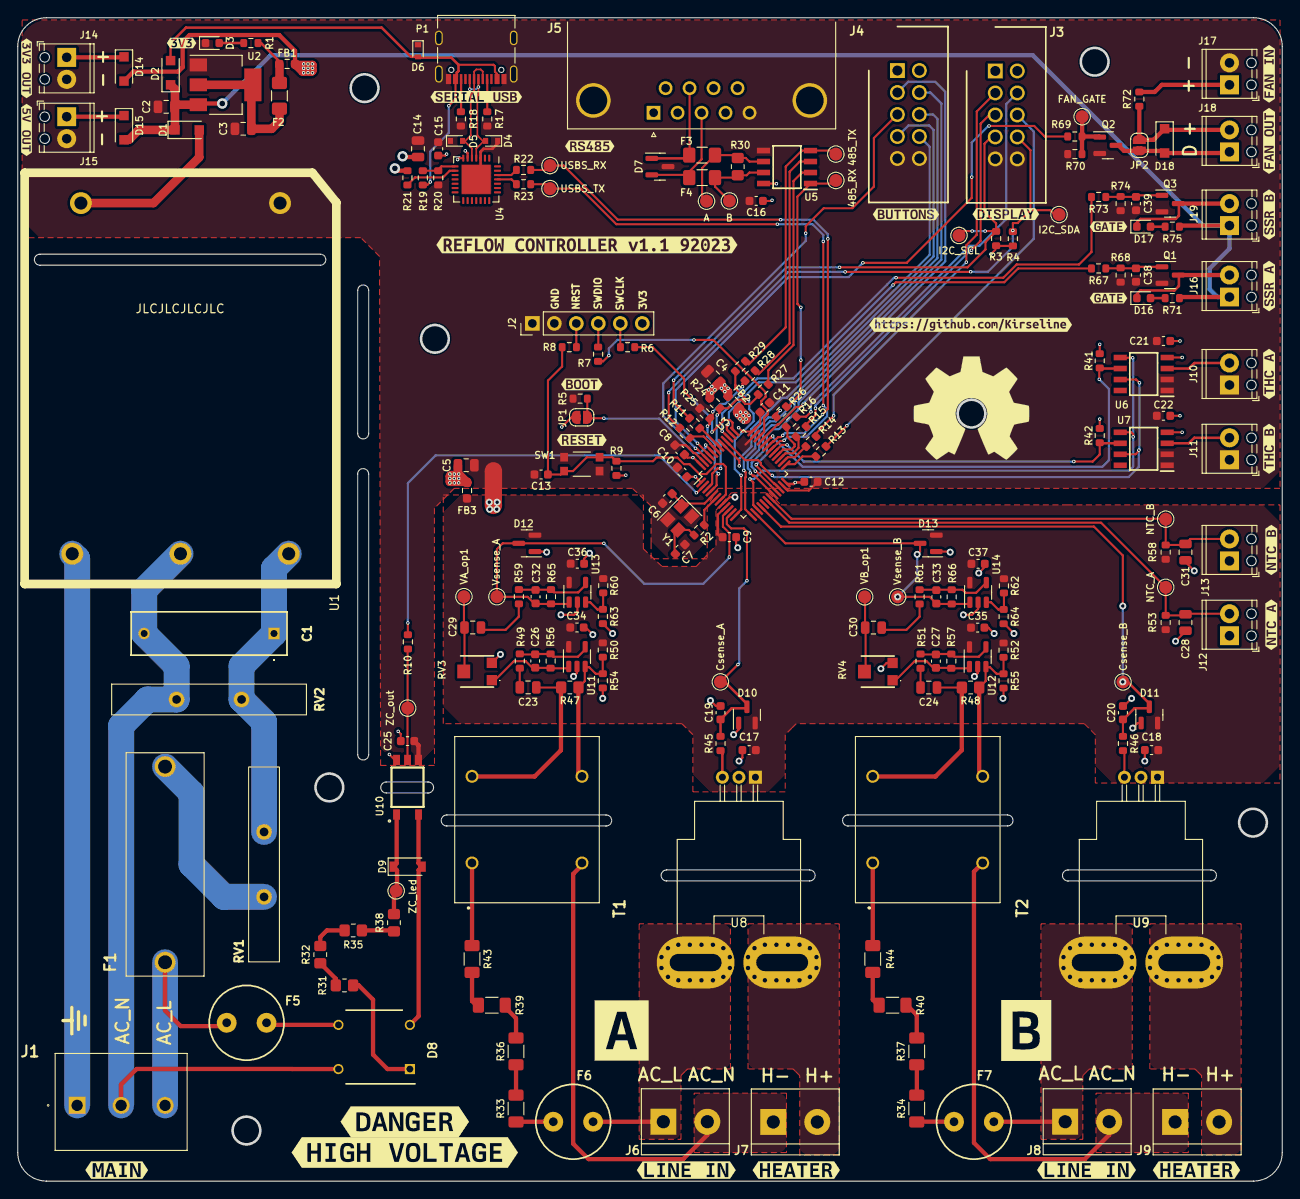
[picture p36: board reflow_oven.kicad_pcb from above]

Board: 2 copper layers, 146.1 x 134.4 mm, 239 parts (0 on the bottom side), 138 nets.

Other parts of the board:
kibuzzard-64E4F8B7: G***; kibuzzard-64E4F8B7
kibuzzard-64E4F9A0, kibuzzard-64E4F9A0#2: G***; kibuzzard-64E4F9A0
kibuzzard-64E4F9DC: G***; kibuzzard-64E4F9DC
kibuzzard-64E4F49B: G***; kibuzzard-64E4F49B
kibuzzard-64E4F476: G***; kibuzzard-64E4F476
kibuzzard-64E4F882: G***; kibuzzard-64E4F882
kibuzzard-64E4F997, kibuzzard-64E4F997#2: G***; kibuzzard-64E4F997
kibuzzard-64E4FDFA: G***; kibuzzard-64E4FDFA
kibuzzard-64E4FE01: G***; kibuzzard-64E4FE01
kibuzzard-64E5CE1E: G***; kibuzzard-64E5CE1E
kibuzzard-64E5CE2C: G***; kibuzzard-64E5CE2C
kibuzzard-64E5FA1C, kibuzzard-64E5FA1C#2: G***; kibuzzard-64E5FA1C
kibuzzard-64E5FC4C: G***; kibuzzard-64E5FC4C
kibuzzard-64E5FC57: G***; kibuzzard-64E5FC57
kibuzzard-64E5FCEC: G***; kibuzzard-64E5FCEC
kibuzzard-64E50E47: G***; kibuzzard-64E50E47
kibuzzard-64E62C67: G***; kibuzzard-64E62C67
kibuzzard-64E602C4: G***; kibuzzard-64E602C4
kibuzzard-64E607E3: G***; kibuzzard-64E607E3
kibuzzard-64E610EC: G***; kibuzzard-64E610EC
kibuzzard-64E624F7: G***; kibuzzard-64E624F7
kibuzzard-64E625F5: G***; kibuzzard-64E625F5
kibuzzard-64E5011B: G***; kibuzzard-64E5011B
kibuzzard-64E6252A: G***; kibuzzard-64E6252A
kibuzzard-64E50110: G***; kibuzzard-64E50110
kibuzzard-64E50301: G***; kibuzzard-64E50301
kibuzzard-64E62979: G***; kibuzzard-64E62979
