Kirseline/PCB-OVEN/Firmware/test_f746/test_i2c/Core/Src/main.c

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
/* Includes ------------------------------------------------------------------*/
#include "main.h"
#include "string.h"

/* USER CODE BEGIN Includes */
//#include "fonts.h"
//#include "ssd1306.h"
#include "GEVA.h"
//#include "GEVA_font.h"
#include "stm32_ssd1306_i2c.h"

/* USER CODE END Includes */

#if defined ( __ICCARM__ ) /*!< IAR Compiler */
#pragma location=0x2004c000
ETH_DMADescTypeDef  DMARxDscrTab[ETH_RX_DESC_CNT]; /* Ethernet Rx DMA Descriptors */
#pragma location=0x2004c0a0
ETH_DMADescTypeDef  DMATxDscrTab[ETH_TX_DESC_CNT]; /* Ethernet Tx DMA Descriptors */

#elif defined ( __CC_ARM )  /* MDK ARM Compiler */

__attribute__((at(0x2004c000))) ETH_DMADescTypeDef  DMARxDscrTab[ETH_RX_DESC_CNT]; /* Ethernet Rx DMA Descriptors */
__attribute__((at(0x2004c0a0))) ETH_DMADescTypeDef  DMATxDscrTab[ETH_TX_DESC_CNT]; /* Ethernet Tx DMA Descriptors */

#elif defined ( __GNUC__ ) /* GNU Compiler */
ETH_DMADescTypeDef DMARxDscrTab[ETH_RX_DESC_CNT] __attribute__((section(".RxDecripSection"))); /* Ethernet Rx DMA Descriptors */
ETH_DMADescTypeDef DMATxDscrTab[ETH_TX_DESC_CNT] __attribute__((section(".TxDecripSection")));   /* Ethernet Tx DMA Descriptors */

#endif

ETH_TxPacketConfig TxConfig;

ETH_HandleTypeDef heth;

I2C_HandleTypeDef hi2c1;

UART_HandleTypeDef huart3;

PCD_HandleTypeDef hpcd_USB_OTG_FS;

void SystemClock_Config(void);
static void MX_GPIO_Init(void);
static void MX_ETH_Init(void);
static void MX_I2C1_Init(void);
static void MX_USART3_UART_Init(void);
static void MX_USB_OTG_FS_PCD_Init(void);
/**
  * @brief  The application entry point.
  * @retval int
  */
int main(void)
{
  /* USER CODE BEGIN 1 */


  /* MCU Configuration--------------------------------------------------------*/

  /* Reset of all peripherals, Initializes the Flash interface and the Systick. */
  HAL_Init();

  /* USER CODE BEGIN Init */
  video_buffer vid_buf;
  /* USER CODE END Init */

  /* Configure the system clock */
  SystemClock_Config();

  /* Initialize all configured peripherals */
  MX_GPIO_Init();
  MX_ETH_Init();
  MX_I2C1_Init();
  MX_USART3_UART_Init();
  MX_USB_OTG_FS_PCD_Init();
  /* USER CODE BEGIN 2 */
  //int a = SSD1306_Init();
  
  /* USER CODE END 2 */  

  //  SSD1306_GotoXY (0,0);
  //  SSD1306_Puts ("HELLO", &Font_11x18, 1);
  //  SSD1306_Puts ("  WORLD :)", &Font_11x18, 1);
  //  SSD1306_UpdateScreen(); //display
  /* Infinite loop */
  /* USER CODE BEGIN WHILE */

  
  init_buf(&vid_buf, 128, 64);
  
  
  set_mode(NORMAL, &vid_buf);
  set_orientation(PORTRAIT, &vid_buf);
  set_mode(INVERTED, &vid_buf);
  //put_string(0, 10, (uint8_t*)"CPU freq: 78MHz\n\rI2C SPEED: 975kbps", SMALL, &vid_buf);
  put_pixel(0,0,SET_C,&vid_buf);
  put_pixel(0,0,CLEAR_C,&vid_buf);
  init_display(0x3C, &hi2c1);
  update_display(&vid_buf);
  
  while (1)
  {
    /* USER CODE END WHILE */
    if(HAL_GPIO_ReadPin(USER_Btn_GPIO_Port,USER_Btn_Pin))
      HAL_GPIO_WritePin(GPIOB, LD1_Pin, GPIO_PIN_SET);
    else
      HAL_GPIO_WritePin(GPIOB, LD1_Pin, GPIO_PIN_RESET);
  }
}

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
