Kirseline/PCB-OVEN/Firmware/test_f746/test_i2c/Core/Inc/GEVA_font.h

#ifndef __FONT__
#define __FONT__

#include <stdint.h>
    
#define C_HEIGHT_S 7    //small
#define C_WIDTH_S 5

#define C_HEIGHT_M 14   //medium
#define C_WIDTH_M 10

#define C_HEIGHT_L 10   //large
#define C_WIDTH_L 12

uint8_t font_height = 0;
uint8_t font_width = 0; 

uint16_t font_s[256][7] = {

    { 0xf800, 0xf800, 0xf800, 0xf800, 0xf800, 0xf800, 0xf800 },   // NULL
    { 0x7000, 0x8800, 0xd800, 0x8800, 0xa800, 0x8800, 0x7000 },   //☺
    { 0x7000, 0xf800, 0xa800, 0xf800, 0xd800, 0xf800, 0x7000 },   //☻
    { 0x5000, 0xf800, 0xf800, 0xf800, 0x7000, 0x2000, 0x0000 },   //♥
    { 0x0000, 0x2000, 0x7000, 0xf800, 0x7000, 0x2000, 0x0000 },   //♦
    { 0x7000, 0x7000, 0xf800, 0xf800, 0x2000, 0xf800, 0x0000 },   //♣
    { 0x2000, 0x7000, 0xf800, 0xf800, 0xf800, 0x2000, 0xf800 },   //♠
    { 0x0000, 0x0000, 0x7000, 0x7000, 0x7000, 0x0000, 0x0000 },   //•
    { 0x0000, 0xf800, 0x8800, 0x8800, 0x8800, 0xf800, 0x0000 },   //◘
    { 0x0000, 0x7000, 0x8800, 0x8800, 0x8800, 0x7000, 0x0000 },   //○
    { 0xf800, 0x8800, 0x7000, 0x7000, 0x7000, 0x8800, 0xf800 },   //◙
    { 0x0000, 0x3800, 0x1800, 0x6800, 0xa000, 0x4000, 0x0000 },   //♂
    { 0x7000, 0x8800, 0x8800, 0x7000, 0x2000, 0x7000, 0x2000 },   //♀
    { 0x2000, 0x3000, 0x2800, 0x2000, 0x6000, 0xe000, 0x4000 },   //♪
    { 0x0800, 0x1800, 0x2800, 0x4800, 0x5800, 0xd800, 0xc000 },   //♫
    { 0x0000, 0xa800, 0x7000, 0xd800, 0x7000, 0xa800, 0x0000 },   //☼
    { 0x0000, 0x4000, 0x6000, 0x7000, 0x6000, 0x4000, 0x0000 },   //►
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
    { 0x2800, 0x5000, 0x8800, 0xc800, 0xa800, 0x9800, 0x8800 },  //Ñ
    { 0x6000, 0x1000, 0x3000, 0x5000, 0x2000, 0x0000, 0x0000 },  //ª
    { 0x2000, 0x5000, 0x2000, 0x0000, 0x0000, 0x0000, 0x0000 },  //º
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

};


//uint16_t (*font)[];

#endif
