Kirseline/PCB-OVEN/(commit log)

2023-07-31 power stage
    schematic of power stage done
    [PCB oven controller.sdf, Power Stage.kicad_sch, chamber dimension.ods, reflow_oven.kicad_pcb, reflow_oven.kicad_sch]
2023-08-04 schematic
    added microcontrroller and .ioc file
    added usb serial converter
    [Actuation.kicad_sch, Interfaces.kicad_sch, MCU_User.kicad_sch, Power Stage.kicad_sch, Sensors.kicad_sch, reflow_oven.kicad_sch]
2023-08-05 interface
    partial interface schematic
    [Interfaces.kicad_sch, MCU_User.kicad_sch, Power Stage.kicad_sch, reflow_oven.kicad_sch]
2023-08-07 analog Sensing
    -voltage and current sensor
    -zero crossing
    -temperature
    [Interfaces.kicad_sch, MCU_User.kicad_sch, Power Stage.kicad_sch, Sensors.kicad_sch, reflow_oven.kicad_pcb, reflow_oven.kicad_sch]
2023-08-08 schematic
    -interface
    -micro
    todo
    output
    routing
    [Interfaces.kicad_sch, MCU_User.kicad_sch, Sensors.kicad_sch, reflow_oven.kicad_pcb, reflow_oven.kicad_sch]
2023-08-11 functionality
    done output stage
    [Actuation.kicad_sch, MCU_User.kicad_sch, Power Stage.kicad_sch, reflow_oven.kicad_pcb, reflow_oven.kicad_sch]
2023-08-11 pcb layout
    initial pcb layout
    [reflow_oven.kicad_pcb]
2023-08-14 addon
    - ferrites application notes
    [Actuation.kicad_sch, Sensors.kicad_sch]
2023-08-22 pcb layout
    [Sensors.kicad_sch, reflow_oven.kicad_pcb, reflow_oven.kicad_sch]
2023-08-23 production candidate
    finished routing
    [reflow_oven.kicad_pcb, reflow_oven.kicad_sch]
2023-08-24 fab out
    added fabrication output
    [reflow_oven-B_Cu.gbl, reflow_oven-B_Mask.gbs, reflow_oven-B_Paste.gbp, reflow_oven-B_Silkscreen.gbo, reflow_oven-Edge_Cuts.gm1, reflow_oven-F_Cu.gtl, reflow_oven-F_Mask.gts, reflow_oven-F_Paste.gtp]
2023-08-24 new board
    user input board
    note: can be etched at home
    [PCB oven controller.sdf, User Board.kicad_pcb, User Board.kicad_sch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]
2023-08-25 fix
    changed display footprint
    [User Board.kicad_pcb, User Board.kicad_sch]
2023-08-26 addon
    documentation pics
    adjust oshw logo
    [Actuation.kicad_sch, Interfaces.kicad_sch, MCU_User.kicad_sch, Power Stage.kicad_sch, Sensors.kicad_sch, reflow_oven.kicad_pcb, reflow_oven.kicad_sch]
2023-09-01 addon
    test nucleo f746
    [MCU_User.kicad_sch]
2023-09-06 documentazione
    aggiunta documentazione
    [Actuation.kicad_sch, MCU_User.kicad_sch, Sensors.kicad_sch, reflow_oven.kicad_sch]
2023-09-07 user board
    user board fab file
    [User Board.kicad_pcb]
